bygerardvisuals/Neumology-Adapters/Adaptador inhalador a tubo respirador 22mm V1.0/Imagenes/Ensamblaje-2.jpeg

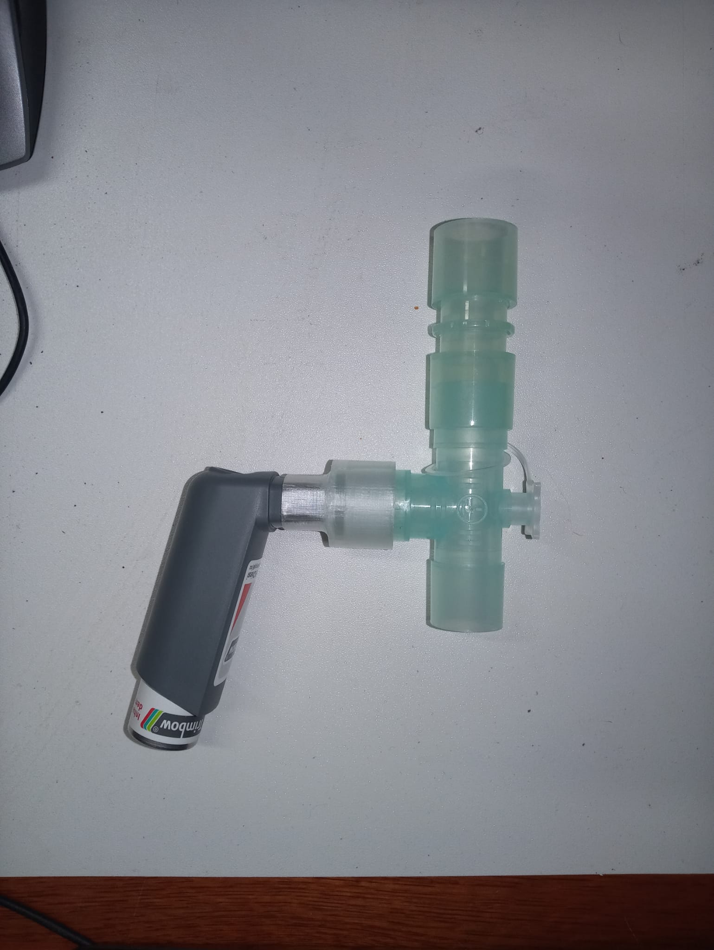
Adaptador inhalador a tubo respirador 22mm V1.0/Imagenes/Ensamblaje-2.jpeg
