bygerardvisuals/Neumology-Adapters/Adaptador inhalador a tubo respirador 22mm V1.0/Imagenes/photo_2020-03-23_19-07-41.jpg

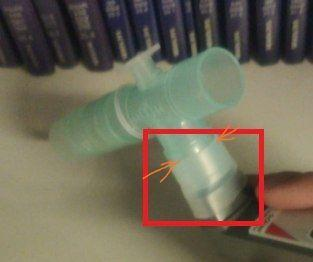
Adaptador inhalador a tubo respirador 22mm V1.0/Imagenes/photo_2020-03-23_19-07-41.jpg
