bygerardvisuals/Neumology-Adapters/Adaptador inhalador a tubo respirador 22mm V1.0/Imagenes/photo_2020-03-24_19-50-04.jpg

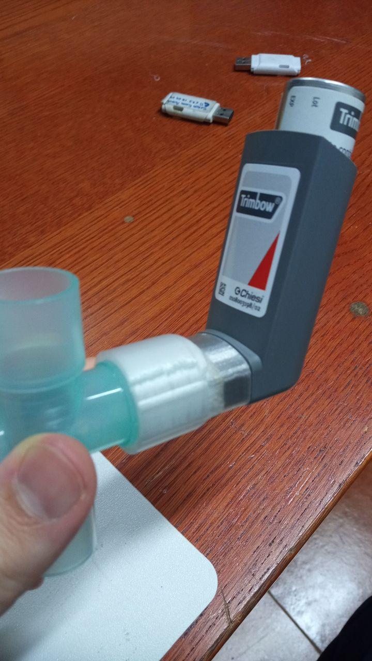
Adaptador inhalador a tubo respirador 22mm V1.0/Imagenes/photo_2020-03-24_19-50-04.jpg
