bygerardvisuals/Neumology-Adapters/Adaptador inhalador a tubo respirador 22mm V1.0/Imagenes/Render-1.png

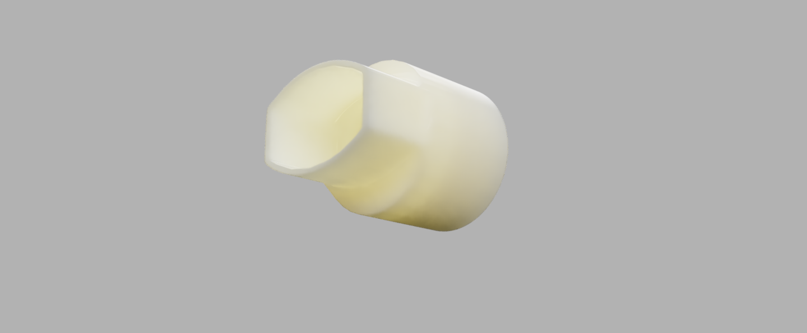
Adaptador inhalador a tubo respirador 22mm V1.0/Imagenes/Render-1.png
