bygerardvisuals/Neumology-Adapters/Adaptador inhalador a tubo respirador 22mm V1.0/Imagenes/Render-3.png

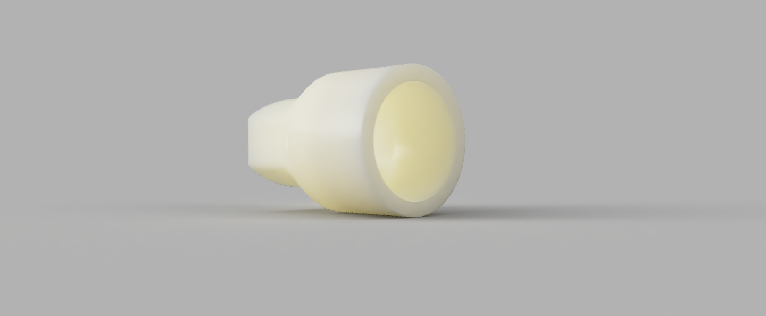
Adaptador inhalador a tubo respirador 22mm V1.0/Imagenes/Render-3.png
