bygerardvisuals/Neumology-Adapters/Mezclador de oxígeno/Mezclador de oxígeno.png

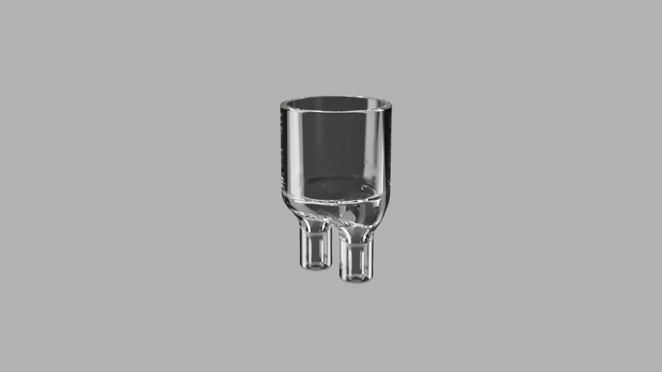
Mezclador de oxígeno/Mezclador de oxígeno.png
