bygerardvisuals/Neumology-Adapters/"T" Connector 22mm to 22mm/Conector Rigido T 22-22.step

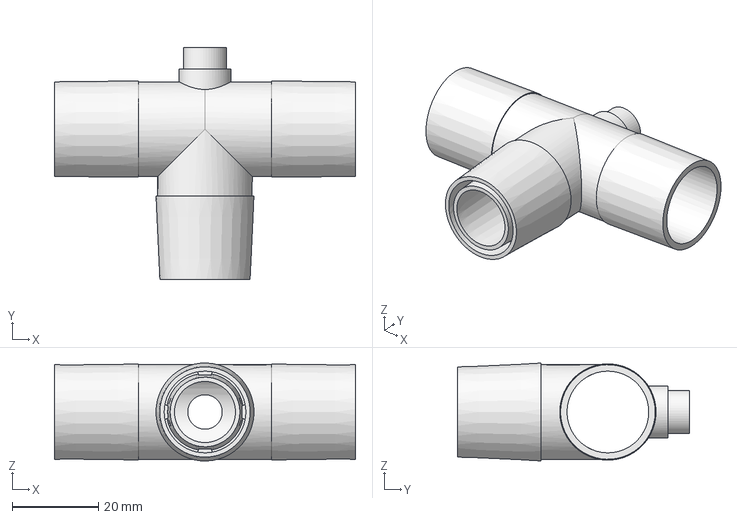
[picture p13: CAD file, 2020-04-01]
"T" Connector 22mm to 22mm/Conector Rigido T 22-22.step
70.0 x 54.0 x 22.8 mm
