bygerardvisuals/Neumology-Adapters/Adaptador 22-15 Pared Doble + V. Antiretorno/Adaptador  22-15 Pared doble + Valvula Antiretorno.step

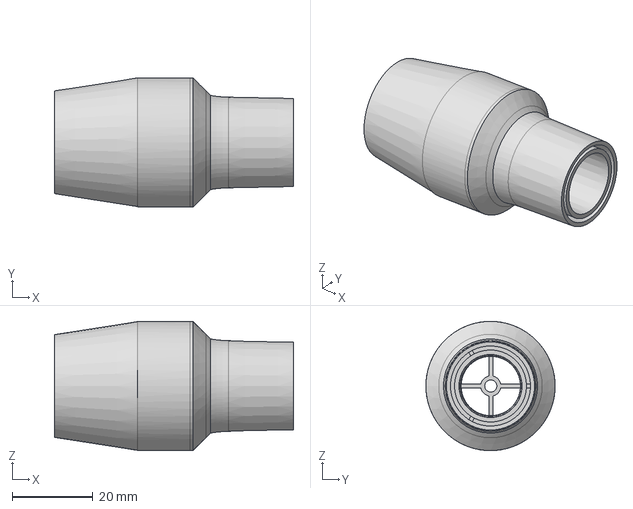
[picture p14: CAD file, 2020-04-02]
Adaptador 22-15 Pared Doble + V. Antiretorno/Adaptador 22-15 Pared doble + Valvula Antiretorno.step
59.1 x 32.0 x 32.0 mm
