bygerardvisuals/Neumology-Adapters/Adaptador 22-15 Pared Doble/Adaptador  22-15 Pared doble v2.step

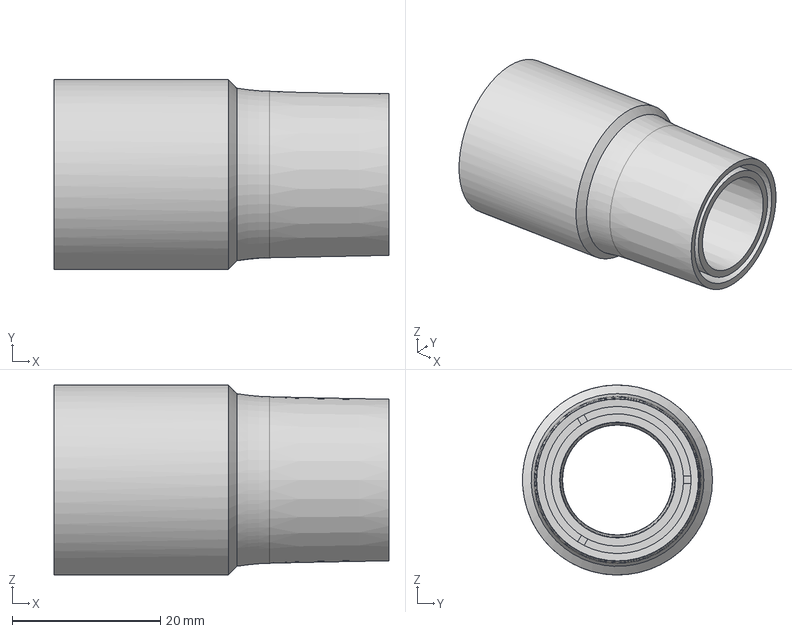
[picture p15: CAD file, 2020-04-02]
Adaptador 22-15 Pared Doble/Adaptador 22-15 Pared doble v2.step
45.1 x 25.6 x 25.6 mm
