bygerardvisuals/Neumology-Adapters/Adaptador inhalador a tubo respirador 22mm V1.0/Modelos/Adaptador Inhalador 22 mm FDM_V1.4.stl

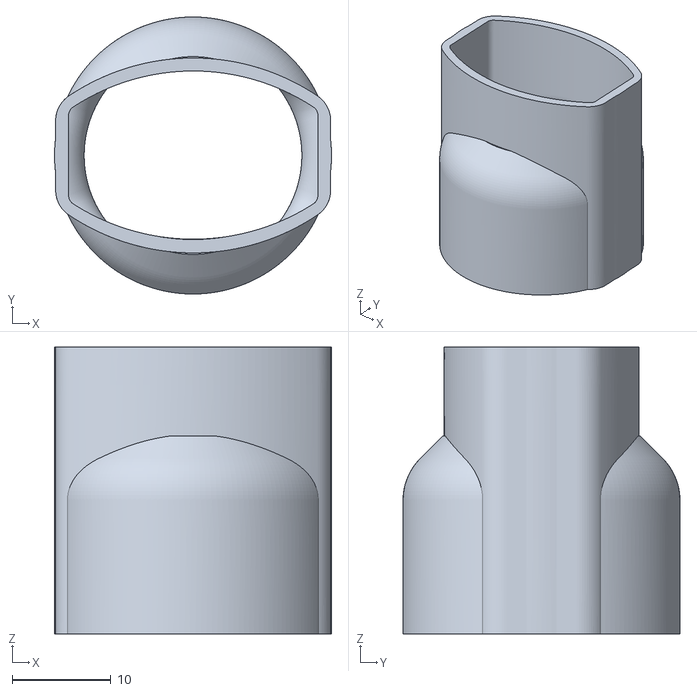
[picture p17: CAD file, 2020-03-28]
Adaptador inhalador a tubo respirador 22mm V1.0/Modelos/Adaptador Inhalador 22 mm FDM_V1.4.stl
28.0 x 28.0 x 29.0
