bygerardvisuals/Neumology-Adapters/Adaptadorde Tubo Flexible (por exterior)/Adaptador Flexible 22-15.step

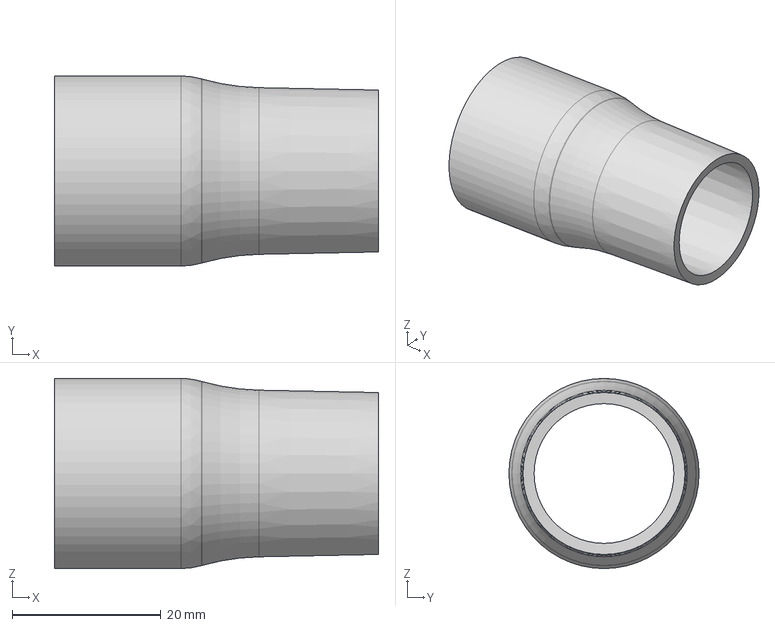
[picture p18: CAD file, 2020-04-01]
Adaptadorde Tubo Flexible (por exterior)/Adaptador Flexible 22-15.step
43.6 x 25.6 x 25.6 mm
