bygerardvisuals/Neumology-Adapters/Conexión codo 58º de tubo 22mm/Conexion Codo 58º tubo 22 mm_FINAL.stp

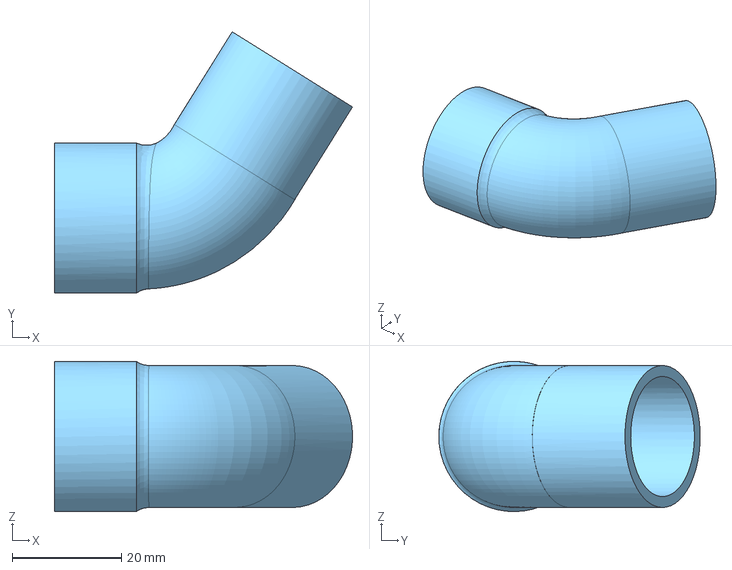
[picture p19: CAD file, 2020-04-01]
Conexión codo 58º de tubo 22mm/Conexion Codo 58º tubo 22 mm_FINAL.stp
54.6 x 47.9 x 27.5 mm
