bygerardvisuals/Neumology-Adapters/Mezclador de oxígeno/Mezclador de oxígeno.stl

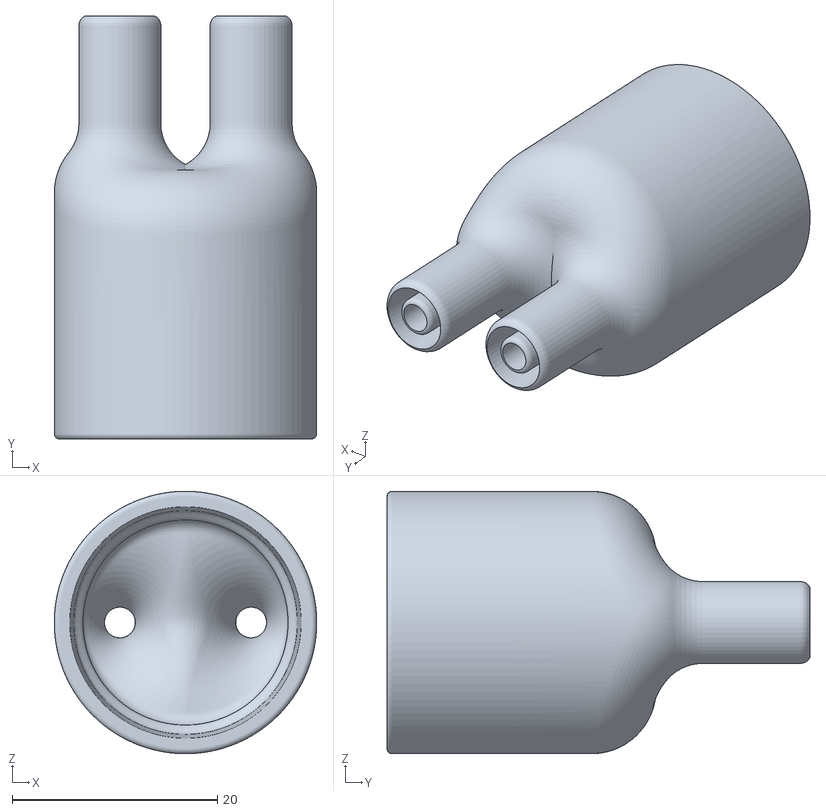
[picture p20: CAD file, 2020-04-04]
Mezclador de oxígeno/Mezclador de oxígeno.stl
25.6 x 41.3 x 25.6
