bygerardvisuals/Neumology-Adapters/Tapones Tubo 22mm 19mm y 15mm/Tapon 19mm.step

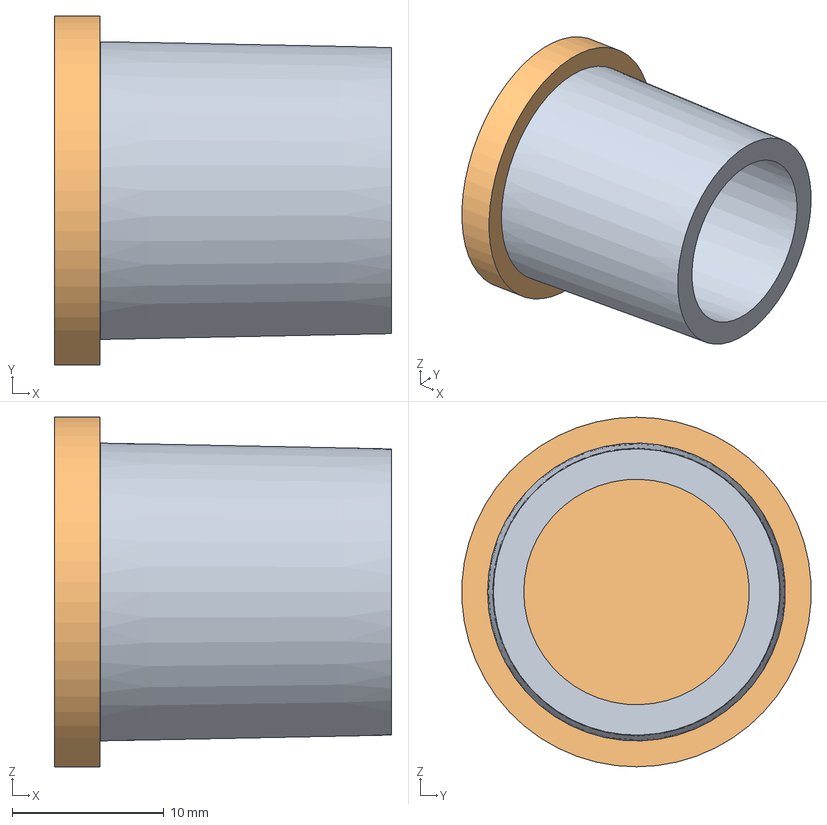
[picture p21: CAD file, 2020-04-01]
Tapones Tubo 22mm 19mm y 15mm/Tapon 19mm.step
22.2 x 23.0 x 23.0 mm
