bygerardvisuals/Neumology-Adapters/Adaptador de Tubo Rígido (por interior)/Conector Rigido 22-22.step

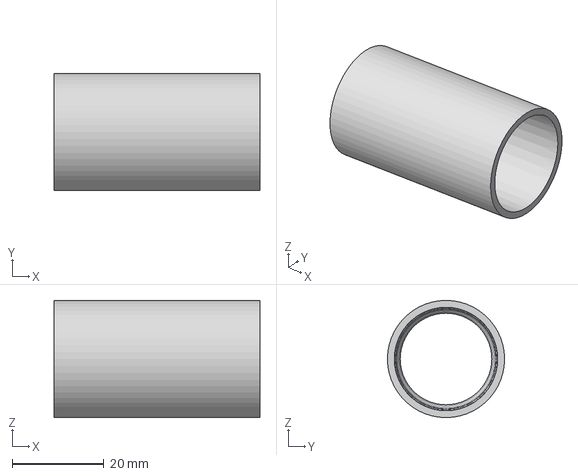
[picture p22: CAD file, 2020-04-01]
Adaptador de Tubo Rígido (por interior)/Conector Rigido 22-22.step
45.0 x 25.6 x 25.6 mm
