bygerardvisuals/Neumology-Adapters/Tapones Tubo 22mm 19mm y 15mm/Tapon 15mm.step

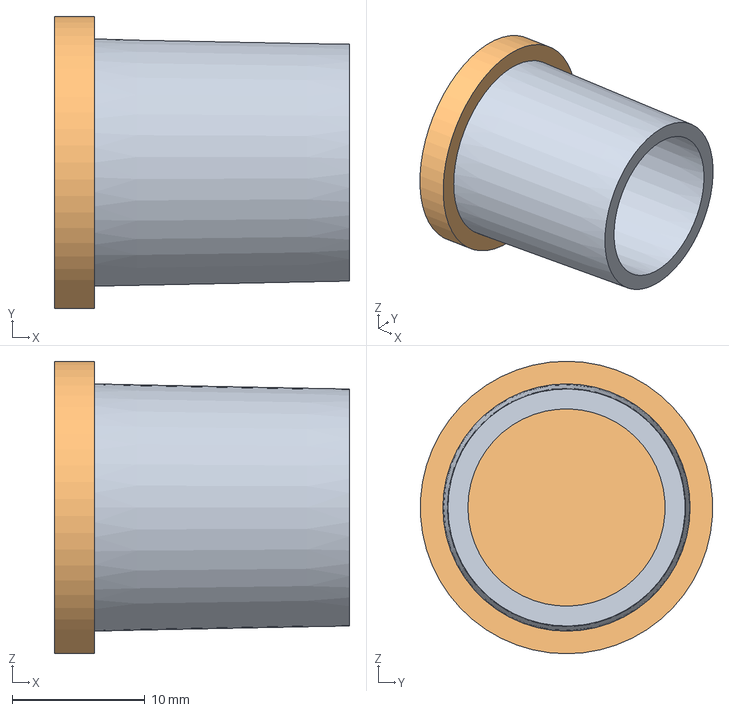
[picture p23: CAD file, 2020-04-01]
Tapones Tubo 22mm 19mm y 15mm/Tapon 15mm.step
22.2 x 22.0 x 22.0 mm
