bygerardvisuals/Neumology-Adapters/(list of files, cad)

Other CAD files:
"T" Connector 22mm to 22mm/Conector Rigidio T 22-22 .stl
Adaptador inhalador a tubo respirador 22mm V1.0/Modelos/Adaptador Inhalador 22 mm_V1.4.stp
Adaptadorde Tubo Flexible (por exterior)/Adaptador Flexible 22-22 v1.stl
Adaptadorde Tubo Flexible (por exterior)/Adaptador Flexible 22-22.step
"T" Connector 22mm to 22mm/Conector Rigido T 22-22.FCStd
Adaptador 22-15 Pared Doble + V. Antiretorno/Adaptador 22-15 Pared doble + Valvula Antiretorno.stl
Adaptador 22-15 Pared Doble/Adaptador 22-15 Pared doble v2.stl
Adaptador de Tubo Rígido (por interior)/Conector Rigido 22-15.stl
Adaptador de Tubo Rígido (por interior)/Conector Rigido 22-22.stl
Adaptador inhalador a tubo respirador 22mm V1.0/Modelos/Adaptador Inhalador 22 mm_V1.4.dwg
Adaptadorde Tubo Flexible (por exterior)/Adaptador Flexible 22-15.stl
Conexión codo 58º de tubo 22mm/Conexion Codo 58º tubo 22 mm_FINAL.stl
Tapones Tubo 22mm 19mm y 15mm/Tapon 15mm.stl
Tapones Tubo 22mm 19mm y 15mm/Tapon 19mm.stl
Tapones Tubo 22mm 19mm y 15mm/Tapon 22mm.stl
