bygerardvisuals/Neumology-Adapters/Adaptador inhalador a tubo respirador 22mm V1.0/Materiales/Vertex-Dental_BE-12-1243-QMD_V1R_Certificate-CE_Issue-8_dd-08-08-2016.pdf

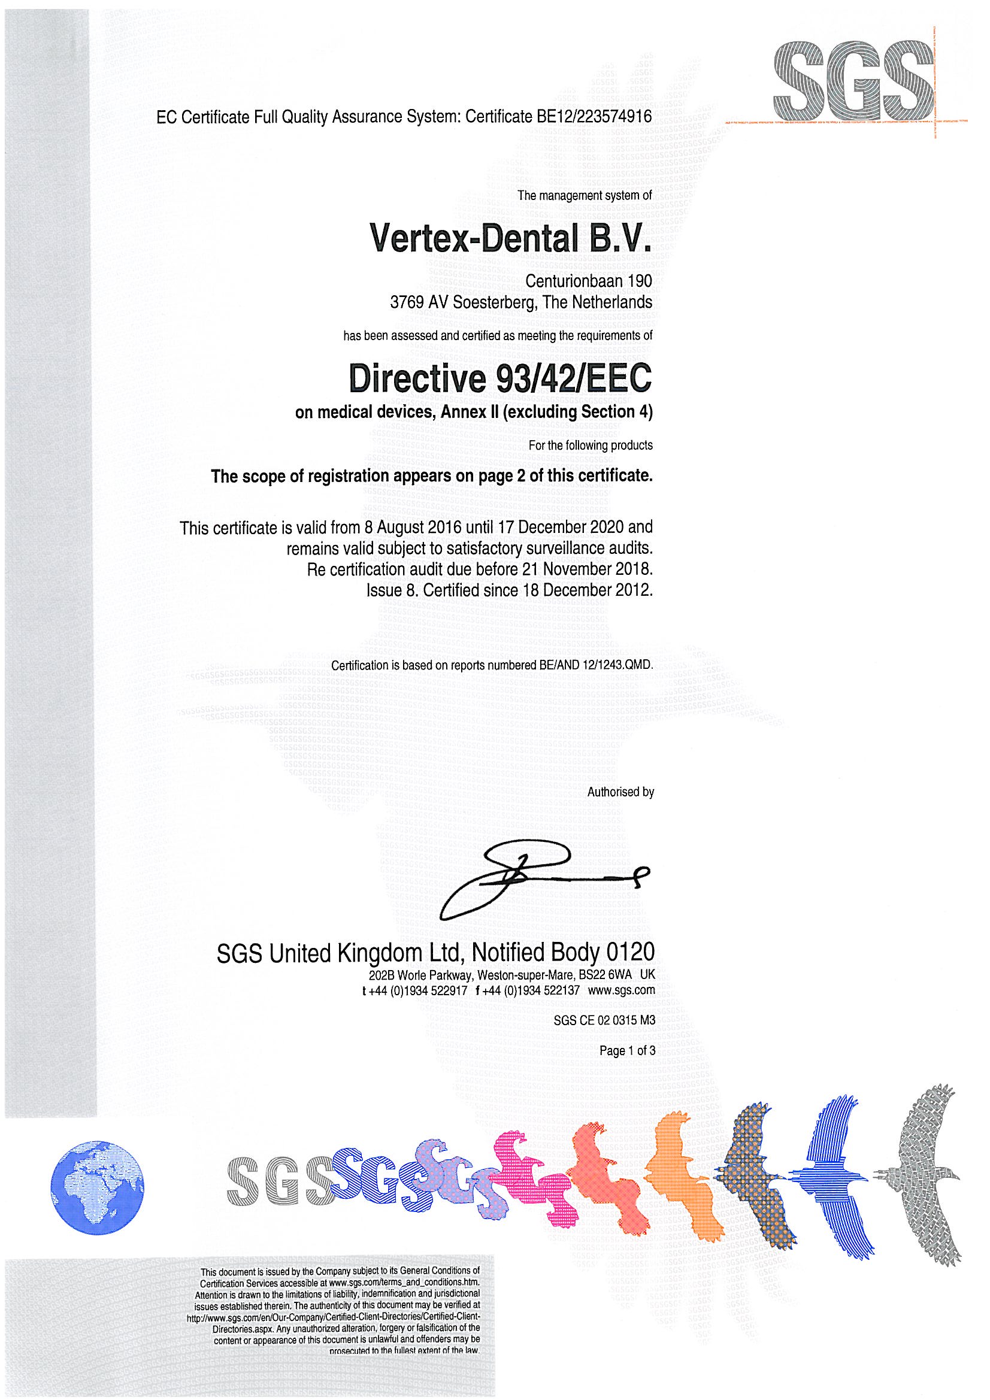
[picture p38: page 1]
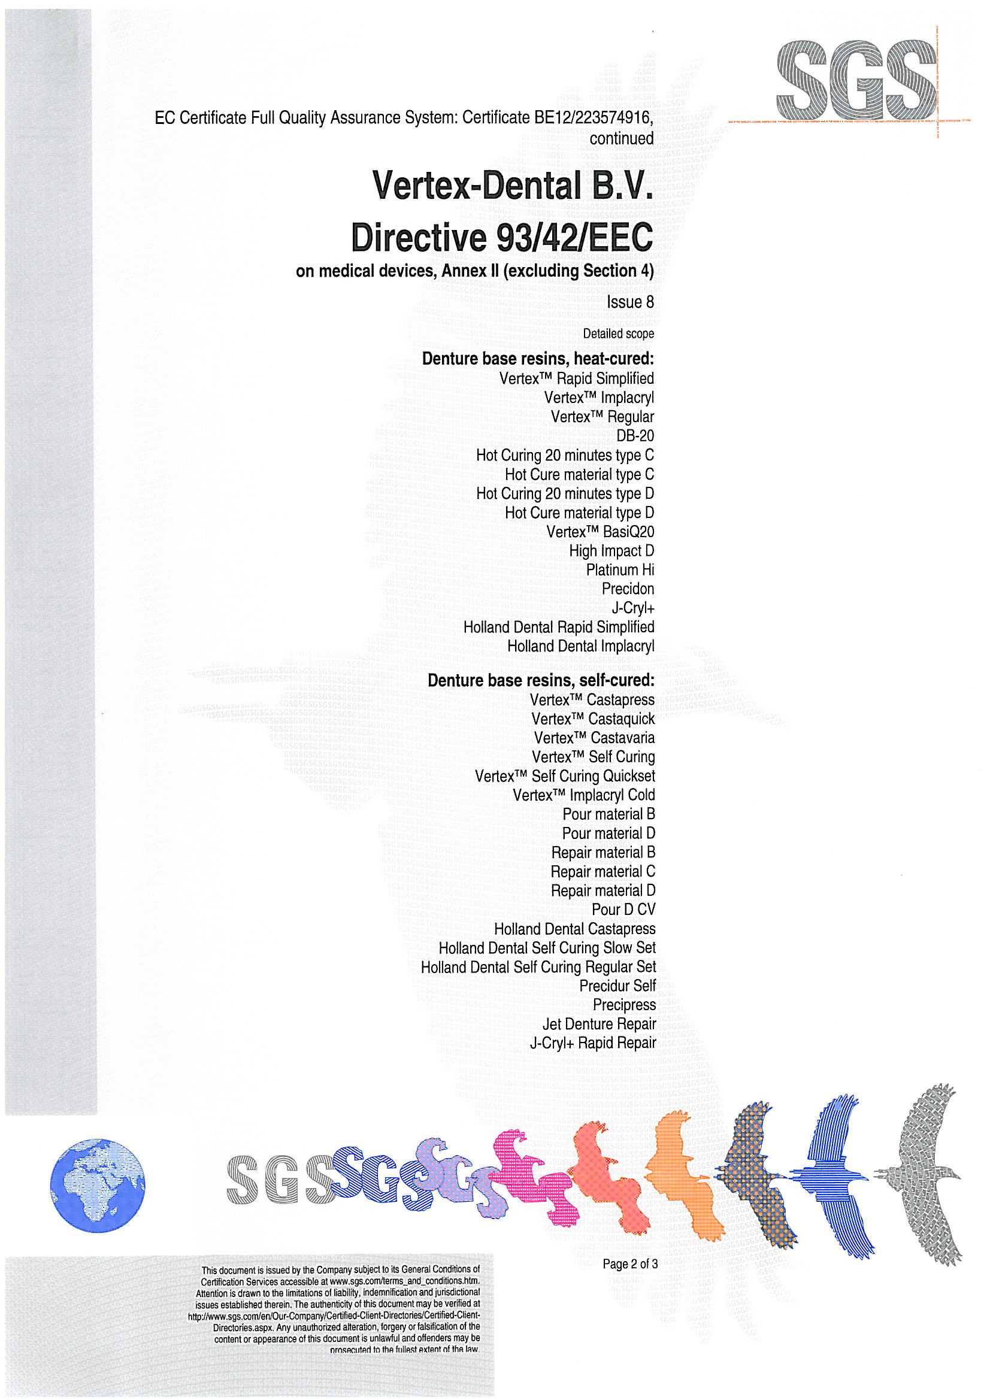
[picture p39: page 2]
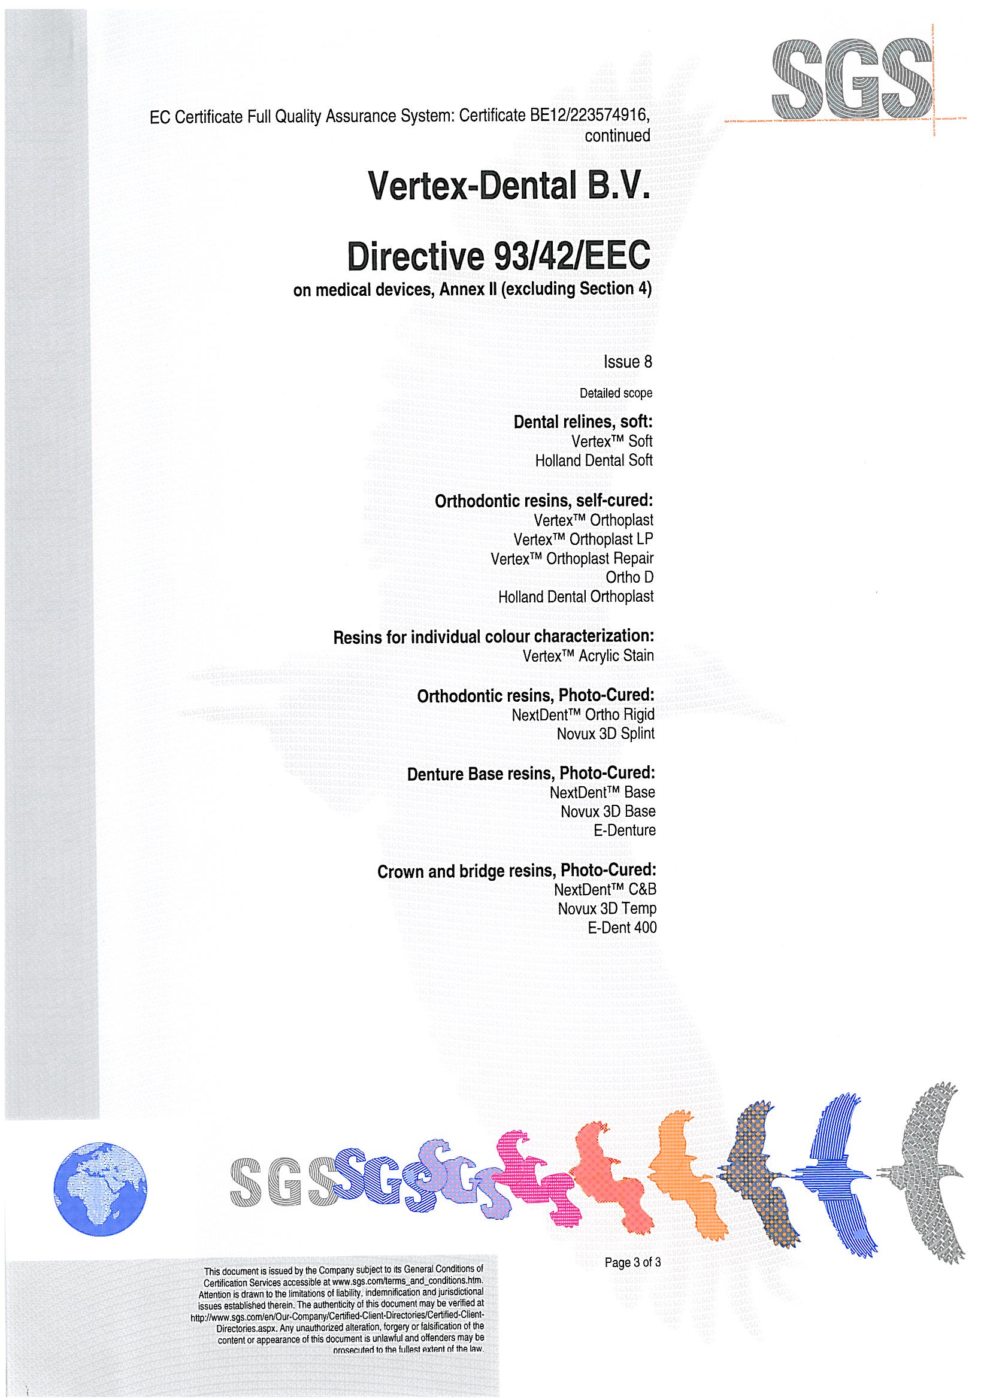
[picture p40: page 3]
