bygerardvisuals/Neumology-Adapters/Adaptador 22-15 Pared Doble/Plano_Adaptador  22-15 Pared doble.pdf

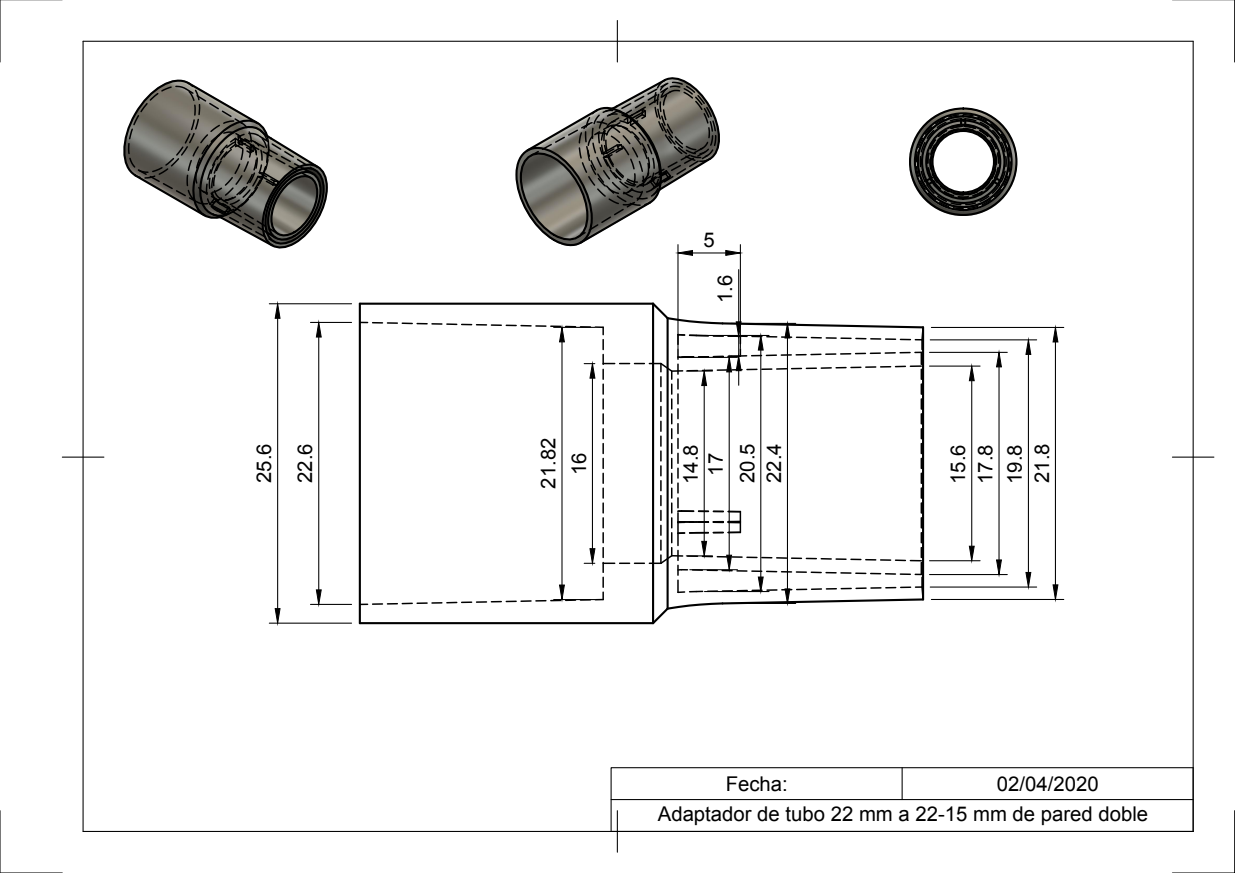
[picture p41: page 1]

Adaptador de tubo 22 mm a 22-15 mm de pared doble
