bygerardvisuals/Neumology-Adapters/Conexión codo 58º de tubo 22mm/Plano_Codo 58º 22mm_FINAL.pdf

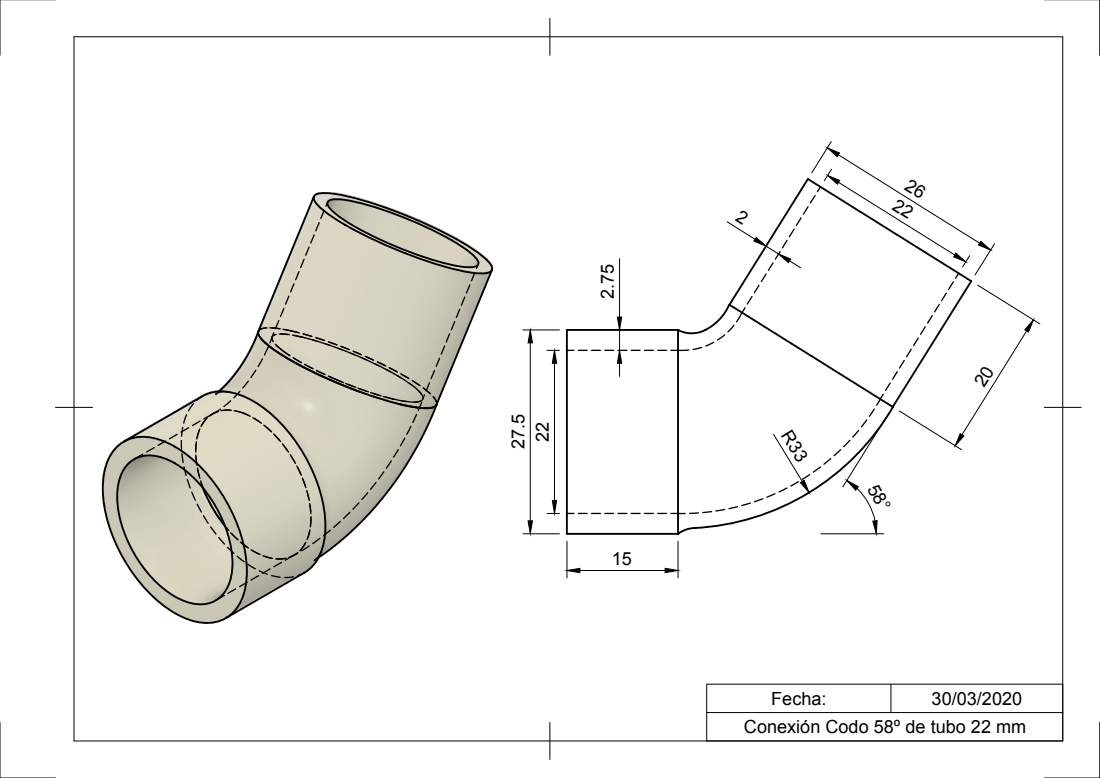
[picture p42: page 1]

Conexión Codo 58º de tubo 22 mm
