bygerardvisuals/Neumology-Adapters/(commit log)

2020-04-01 Create "T" Connector 22mm to 22mm
2020-04-01 Create de
